Ysv2/Terrain-Vehicle/README.md

# Terrain Vehicle

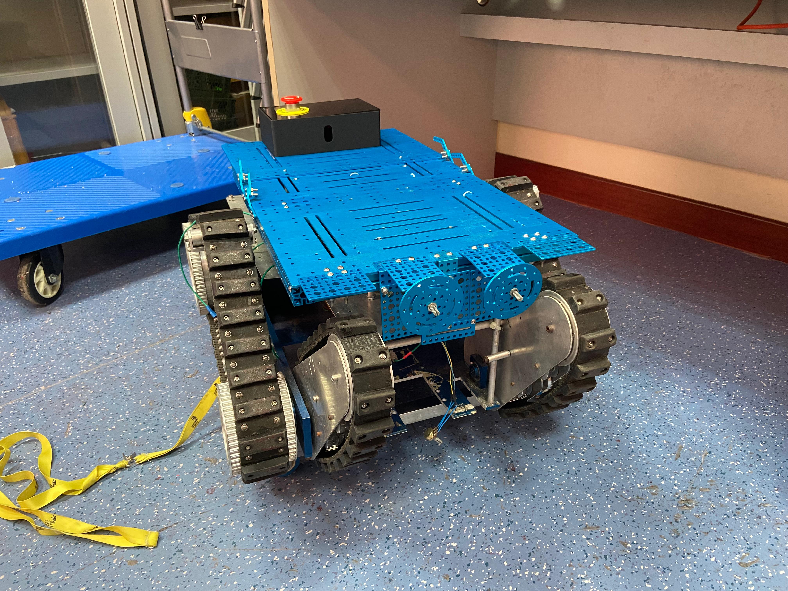
[picture p1: assets/terrainpic.jpg]
Terrain Vehicle


## Introduction

The Terrain Vehicle is a robot designed to traverse uneven terrain. It is controlled using a custom-built remote controller developed by our team.

---

## Documentation

For more details, refer to the following documents:

* [User Guide](./UserGuide.md)
* [Setup Guide](./SetupGuide.md)
* [Technical Guide](./TechnicalGuide.md)
* [Bill of Materials](./Bill_of_Materials.md)

---

## Files

3 main files:

* ardunio_controller
* stm32_reciever
* stm32_transmitter

Other files (used for testing and designing):

* lcd_design
* led_control

---

## Others

Tool for LCD designing: [lopaka](https://lopaka.app)

---
