Ysv2/Terrain-Vehicle/Bill_of_Materials.md

# Bill of Materials (BOM)

> **NOTE:** Prices are old and not updated.

| No. | Name | Qty | Unit Cost ($) | Total Cost ($) | Remarks |
|-----|---|-----|---|---|---|
| 1 | Arduino UNO | 1 | 0 | 0 | From EMC |
| 2 | STM32F103C8T6 | 2 | 2.49 | 4.98 | |
| 3 | 4 Channel IIC I2C Logic Level Converter | 1 | 3.52 | 3.52 | 10 piece |
| 4 | Durable 3–24V Piezo Electronic Buzzer | 1 | 1.47 | 1.47 | |
| 5 | MP1584EN Ultra-small Size DC-DC Step-down Power Supply | 1 | 1.64 | 1.64 | |
| 6 | 2.54mm 1x40 Pin Breakaway Straight Female Header Single Row  | 1 | 1.53 | 1.53 | 10 piece |
| 7 | ON / OFF Rocker Switch | 1 | 1.48 | 1.48 | 10 piece |
| 8 | NRF24L01 w Antenna | 2 | 3.14 | 6.28 | |
| 9 | Dual-axis Joystick Module | 2 | 3.06 | 6.12 | |
| 10  | 4 Channel 5V Relay Module Board | 1 | 3.68 | 3.68 | |
| 11  | LM2596 DC to DC Buck Converter Voltage Regulator | 1 | 3.04 | 3.04 | 3 piece |
| 12  | CP2102 Module USB to TTL Serial UART | 1 | 2.62 | 2.62 | |
| 13  | 0.96 inch IIC 4pin white | 1 | 2.80 | 2.80 | |
| 14  | E Stop Button | 1 | 6.63 | 6.63 | |
| 15  | Buttons | 4 | 0 | 0 | Component Store |
| 16  | Switches 2 & 3 state | 4 | 0 | 0 | Component Store |
| 17  | 9V battery | 1 | 0 | 0 | From EMC |
| 18  | M3 Thread Knurled Brass Threaded Heat Set Insert | 1 | 3.92 | 3.92 | 100 piece |
| | **TOTAL** | | | **49.71** | |
